fabianhdz/stm32f407-oscilloscope/docs/images/o_image.png

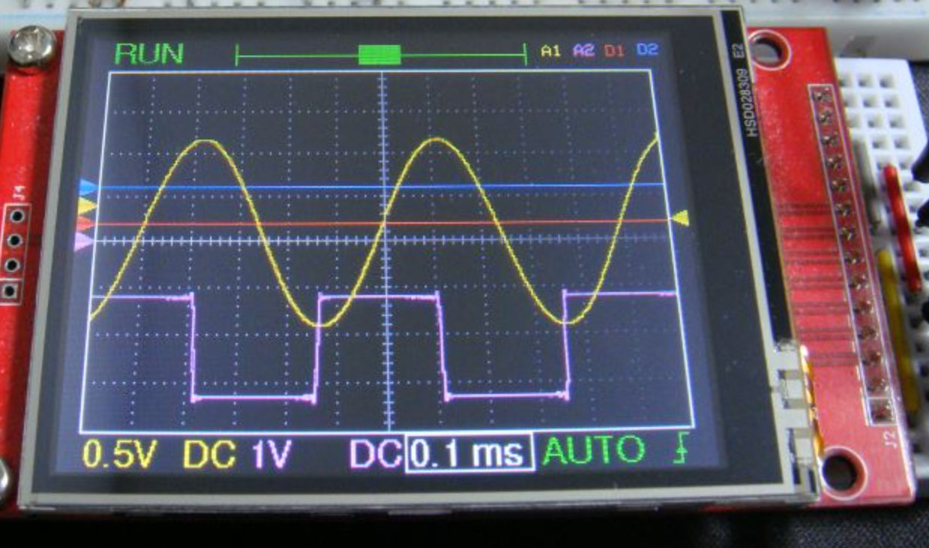
docs/images/o_image.png
