fabianhdz/stm32f407-oscilloscope/hardware/schematic.pdf

### ANALOG INPUT

## U1 STM32F407

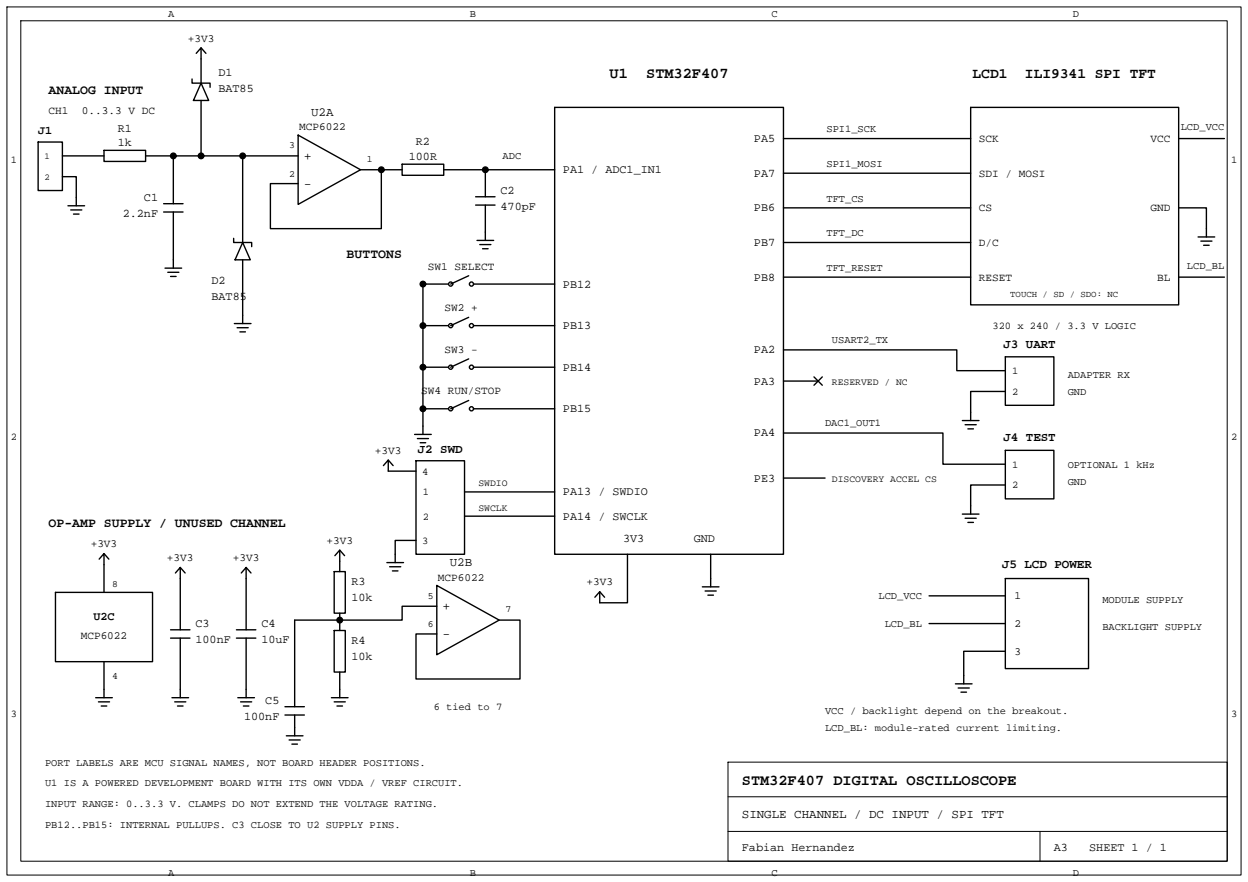
[picture p3: page 1]

TOUCH / SD / SDO: NC

GND DISCOVERY ACCEL CS

OP-AMP SUPPLY / UNUSED CHANNEL

VCC / backlight depend on the breakout.
LCD_BL: module-rated current limiting.

PORT LABELS ARE MCU SIGNAL NAMES, NOT BOARD HEADER POSITIONS.
U1 IS A POWERED DEVELOPMENT BOARD WITH ITS OWN VDDA / VREF CIRCUIT.
INPUT RANGE: 0..3.3 V. CLAMPS DO NOT EXTEND THE VOLTAGE RATING.
PB12..PB15: INTERNAL PULLUPS. C3 CLOSE TO U2 SUPPLY PINS.

SINGLE CHANNEL / DC INPUT / SPI TFT
