fabianhdz/stm32f407-oscilloscope/firmware/app/main.c

#include "board.h"
#include "drivers/uart_log.h"
#include "app/tasks.h"
#include "drivers/demo_dac.h"
void _init(void) {}
void _fini(void) {}
int main(void)
{
    board_init();
    board_pins_init();
    uart_log_init();
    demo_dac_init();
    uart_log("oscilloscope boot: STM32F407 HSI 160MHz, hardware unverified\r\n");
    app_start();
}
