fabianhdz/stm32f407-oscilloscope/(commit log)

2026-04-02 build: pin official HAL CMSIS FreeRTOS and DSP dependencies
2026-04-02 build: add C11 host tests ARM toolchain and shared scope settings
2026-04-02 board: link a bootable Cortex-M4F image within a 512KB flash budget
2026-04-02 board: configure HSI 160MHz clock pins and independent HAL timebase
2026-04-02 drivers: add nonblocking interrupt-driven UART diagnostics
2026-04-03 acquisition: assemble pretrigger captures and reject discontinuous samples
2026-04-03 acquisition: enforce DMA buffer ownership and bounded exhaustion handling
2026-04-03 processing: measure calibrated voltage statistics and RMS
2026-04-06 processing: integrate CMSIS real FFT with Hann window and voltage scaling
2026-04-06 controls: debounce buttons and implement scope parameter editing
2026-04-06 rtos: add immutable latest-frame handoff for slow consumers
2026-04-07 drivers: implement timer-triggered ADC and rotating DMA double buffers
2026-04-07 drivers: transfer TFT pixels through SPI DMA with bounded waits
2026-04-09 demo: add optional timer and DMA driven 1kHz DAC loopback
2026-04-09 hardware: specify the breadboard-friendly parts list
    [bom.csv]
2026-04-09 hardware: document pin assignments and front-end electrical connections
2026-04-09 hardware: draw the buffered input and protection schematic
2026-04-10 build: verify ELF memory budgets and DMA SRAM placement
2026-04-10 test: stress DMA ownership across 100000 producer consumer events
2026-04-10 docs: provide staged hardware bring-up and control instructions
2026-04-13 docs: define voltage and clock calibration procedures
2026-04-13 tools: export stopped ADC captures to calibrated CSV
2026-04-13 tools: record UART telemetry without external Python dependencies
2026-04-13 test: evaluate stress logs for losses stalls and display throughput
2026-04-14 board: bound newlib heap growth separately from static application buffers
2026-04-16 drivers: clear stale TFT interrupts and reset SPI before display recovery
    [tasks.c, tft_bus.c]
2026-04-16 hardware: connect clamp diode leads explicitly in the schematic
2026-04-16 docs: publish build assembly and workflow guide with renderer previews
2026-04-17 hardware: redraw complete scope wiring as a conventional schematic
2026-04-17 docs: remove hardware validation footer from schematic
2026-04-17 docs: condense project guides and remove progress reports
    [bom.csv]
2026-04-21 update bom
    [bom.csv]
2026-04-21 docs: show reference photo and project schematic in README
2026-04-23 hardware: keep MCU schematic labels limited to the part and pins
